neiaHsing/stm32-filament-dryer/docs/TEMPERATURE_CONTROL_ALGORITHM_REPORT.md

# 温度控制系统算法说明与实验报告依据

> 2026-09-17前馈更新：已实测24°C室温下40°C/60°C保温输出28.9611%/53.5925%，当前F22=clip(11.99435×(目标−12.83620),0,850)，再按(目标−室温)/(目标−22)缩放。此前20.13/34.65及旧表为历史值，以本条和`outputs/feedforward_calibration_24c/REPORT.md`为准；旧版实测不代表新曲线验证。

编写依据：2026-09-16 工作区当前源码及已有实测记录。本文不修改控制程序，也不启动设备。公式中的温度单位为 °C，时间为 s，控制输出为千分比（0～1000）。

## 1. 系统定位与总体结构

本系统针对 PTC 加热的烘干装置，通过 STM32 完成温湿度采集、加热功率调节和安全联锁，ESP32 用于状态记录与远程操作。控制对象是传感器所在位置的空气温度，不是耗材内部温度。

当前算法可准确表述为：**基于双传感器加权反馈、保温前馈、温度增益调度、趋势预测、条件积分和限幅降温补偿的离散 PID 型温控算法，外层叠加湿度滞回和安全状态机。**

它不是教科书中直接对温差作 P、I、D 叠加的固定参数 PID，也不是严格模型预测控制 MPC；程序没有在线优化求解器。所谓预测是利用当前升温斜率进行短时间线性外推。

功能链路为：

```text
AHT20 温湿度、BMP280 温度
          ↓ 数据有效性检查
融合温度 T = 0.7 TAHT + 0.3 TBMP ──→ 显示与遥测
          ↓
运行/启动等待/风扇/传感器/过温/湿度许可
          ↓
目标选择 → 保温前馈 + 预测比例 + 有界积分 + 单向微分 + 降温补偿
          ↓ 输出限幅与千分比量化
10 Hz PWM → XY-MOS → PTC → 箱内温度 → 传感器

原始两路温度的较高值 → 独立于融合计算的 75°C 过温判定
```

源码入口：`Core/Src/main.cpp`；核心控制器：`Core/Inc/separation_pid.h`；融合函数：`Core/Inc/temperature_fusion.h`。这里的“独立”指独立判据，过温保护仍是同一 MCU 上的软件功能，不是独立硬件温控器。

## 2. 被控对象特点及算法设计依据

可用下面的简化能量平衡解释设计意图：

\[
C_{eq}\frac{dT}{dt}=P_{eff}(u,T)-Q_{loss}(T,T_a)-Q_{load}-Q_{dist}.
\]

其中，等效热容反映箱体、空气和负载的热惯性；有效加热量受占空比、PTC 温度和供电条件影响；散热和开盖等扰动消耗热量。该式是分析模型，程序没有识别全部参数或实时计算这条方程。

由此可以解释：

1. 温差较大时通常需要较高输出，但接近目标后继续大功率加热会因热惯性发生超调。
2. 达到目标并不意味着可以永久关闭加热，稳态仍需补偿散热，因此引入保温前馈。
3. 温度升高后对象响应变慢，固定参数在不同温区未必具有相近效果，因此引入有界增益调度。
4. 开盖导致的短时掉温不宜全部记入积分，否则盖回后可能释放过多积累输出，因此冻结积分并限制下降趋势补偿。
5. 系统没有主动制冷输出。温度过高时只能减少或关闭加热，依靠原有风流和自然散热降温。

满占空比历史试验记录：30～40°C、40～50°C、50～60°C 的平均升温速度分别为 0.40464、0.36116、0.20173°C/s，支持对象响应随温度变化的判断。该试验采用旧版 max 温度反馈，且没有测电流、电压；“100% 占空比”不能写成“始终恒定 100 W”。

## 3. 温度采样、转换和融合

### 3.1 采样周期与执行周期

- 名义采样周期 1000 ms；AHT20 触发测量后等待至少 85 ms，再读取测量值并读取 BMP280 温度。
- 等待 AHT20 转换采用主循环状态管理，并非固定阻塞 85 ms；I²C 传输本身仍存在同步等待。
- 主循环末尾延时 2 ms，不代表 PID 每 2 ms 运算，也不代表安全反应时间严格等于 2 ms。
- 采样调度错过周期时跳过已错过时隙，不密集补采。
- AHT20 与 BMP280 并非硬件同步采样：BMP280 使用自身正常模式周期，主循环读取最近温度寄存器。

新样本的 PID 时间间隔按 AHT20 的触发时间戳计算：

\[
\Delta t_k=(tick_k-tick_{k-1})/1000.
\]

首次进入控制使用 1 s 初始化。只有新样本、目标变化或 PID 尚未初始化时才重新计算输出。

### 3.2 数据转换与传感器补偿

AHT20 使用 20 位原始数据换算：

\[
RH=100\frac{N_H}{2^{20}},\qquad T_A=200\frac{N_T}{2^{20}}-50.
\]

程序以 0.01°C 和 0.001%RH 整数存储，并检查忙状态及 CRC8，CRC 多项式为 0x31、初始值为 0xFF。

BMP280 从芯片读取 T1、T2、T3 校准参数，对原始温度 ADC 值作整数补偿。若用连续形式帮助理解，可写为：

\[
v_1=\left(\frac{ADC_T}{16384}-\frac{T_1}{1024}\right)T_2,
\]
\[
v_2=\left(\frac{ADC_T}{131072}-\frac{T_1}{8192}\right)^2T_3,
\qquad T_B\approx\frac{v_1+v_2}{5120}.
\]

实际执行的是 `bmp280.c` 中带移位和取整的整数公式，不是直接调用上述浮点式。芯片校准补偿属于测量处理；后文的保温和降温补偿属于控制输出处理，两者不可混称。

### 3.3 数据有效性及融合

两路温度均须位于 −40～85°C；相对湿度不得超过 100%RH；任一必要读数或通信校验失败，则整个温湿度样本无效。加热运行中不会自动退化成单传感器控制。

反馈量为：

\[
T_k=0.7T_{A,k}+0.3T_{B,k}.
\]

融合后保留到 0.01°C，正负数的恰好半步均向远离零的方向舍入。例如 39.70°C 与 40.10°C 得到 39.82°C。PID、显示、网页和遥测使用同一融合温度；OLED 的显示格式再取到 0.1°C。

0.7/0.3 是固定权重，当前实现不是卡尔曼滤波，也没有在线估计传感器置信度。加权平均可以改变两路噪声和偏差对结果的贡献，但若无独立标准温度计校准，不能宣称该比例必然最优或具有 0.01°C 的绝对测量精度。数值分辨率不等于准确度。

过温判据另外使用：

\[
T_{safe,k}=\max(T_{A,k},T_{B,k}).
\]

因此较低的一路不会通过加权平均掩盖另一路达到 75°C 的情况。当前代码没有额外的双传感器温差故障阈值。

## 4. 控制器变量、参数与总公式

定义限幅函数：

\[
\operatorname{clip}(x,a,b)=\min(\max(x,a),b).
\]

| 符号 | 物理意义 | 当前值或范围 |
|---|---|---|
| r | 温度目标 | 用户目标 30～70°C；温度关闭但湿度开启时取 70°C |
| e=r−T | 当前温差 | °C |
| u | 输出千分比 | 0～1000 |
| Kp | 比例基准系数 | 200 千分比/°C |
| Ki | 积分基准系数 | 2 千分比/(°C·s) |
| Kd | 微分基准系数 | 180 千分比·s/°C |
| Esep | 积分分离阈值 | 2°C |
| I | 积分输出修正 | −250～250 千分比 |
| v | 滤波温升速率 | °C/s，滤波时间常数参数 1 s |
| H | 近期输出滤波量 | 千分比，滤波时间常数参数 4 s |

内部浮点输出公式为：

\[
u_k=\operatorname{clip}(F_k+P_k+I_k+D_k+B_k,0,U_{max,k}).
\]

F 为保温前馈；P 为预测误差比例项；I 为残差积分；D 为单向升温制动；B 为限幅降温补偿。执行层将结果四舍五入到整数千分比后写入 PWM。

## 5. 保温前馈

\[
F_{22}(r)=\operatorname{clip}\left[11.99435(r-12.83620),0,850\right],
\qquad F(r,T_a)=\operatorname{clip}\left[F_{22}(r)\frac{\max(r-T_a,0)}{r-22},0,850\right].
\]

| 目标温度（室温设为 22°C） | 前馈千分比 | 对应占空比 |
|---|---:|---:|
| 30°C | 205.87 | 20.587% |
| 40°C | 325.81 | 32.581% |
| 50°C | 445.76 | 44.576% |
| 55°C | 505.73 | 50.573% |
| 60°C | 565.70 | 56.570% |
| 70°C | 685.64 | 68.564% |

2026-09-17 在 24°C 室温下实测目标 40°C 和 60°C 的末段平均保温输出分别为 289.61‰ 和 535.93‰，再归一化为 22°C 基准后拟合出斜率 11.99435、偏移量 12.83620。目标 40°C、22°C 室温时前馈约 32.581%，目标 60°C、22°C 室温时约 56.570%；其它目标和室温仍属于曲线估计。

`ROOM TEMP CAL` 菜单输入当前箱外室温 Ta（−10～50°C、1°C 步进，默认 22°C），按温差比例缩放新版前馈。所有合法目标为 30～70°C，分母始终为正；函数对目标不高于 22°C 或室温不低于目标的情况返回零前馈。以目标 40°C 为例，室温 10/22/28°C 对应约 54.302%/32.581%/21.721% 前馈；目标 60°C、室温 24°C 对应约 53.593%。当前曲线有两个目标点的实测支撑，仍需更多环境、负载和风量条件验证；只改变前馈及使用该前馈的下降补偿计算，传感器融合、满功率速率表、PID 参数和独立过温阈值不变。设置在停机菜单最终确认时应用，W25Q v3 保存室温，v1/v2 记录兼容回退至 22°C。完整数据见 `outputs/feedforward_calibration_24c/REPORT.md`。

前馈使系统在误差接近零时仍具有补偿散热的基础输出，积分只需修正前馈不准的部分。它不能保证所有装载和环境下的准确保温。前馈最高 85% 也不意味着总输出最高 85%；比例、积分等叠加后总输出仍可到 100%。

## 6. 温度相关增益调度

程序内置满占空比升温速度表，单位 °C/s：

| 温度节点 | 35.5 | 40.5 | 45.5 | 50.5 | 55.5 | 59.5 |
|---|---:|---:|---:|---:|---:|---:|
| R(T) | 0.4533 | 0.4346 | 0.3619 | 0.2761 | 0.2058 | 0.1420 |

节点间线性插值：

\[
R(T)=R_i+\frac{T-T_i}{T_{i+1}-T_i}(R_{i+1}-R_i).
\]

低于 35.5°C 保持首节点值，高于 59.5°C 保持末节点值，不继续外推下降曲线。该表是程序采用的平滑表，不能与历史报告的 5°C 分段平均值直接混用。

增益系数为：

\[
g_k=\operatorname{clip}\left(\frac{0.4346}{R(T_k)},0.8,2.0\right).
\]

P、I 增量、D 都乘以 g。40.5°C 时 g=1；50.5°C 时约 1.574；55.5°C 时比值约 2.112，实际限到 2。

设计意图是响应变慢时增强控制作用，同时避免无界放大。这属于经验增益调度；满功率净升温率不等同于任意工作点的小信号对象增益，也没有由此证明全温区稳定性。尤其 60～70°C 缺少相应速度标定，应在报告中列为验证边界。

## 7. 斜率滤波与预测减功率

### 7.1 测量微分及滤波

先算测量斜率：

\[
s_k=\frac{T_k-T_{k-1}}{\Delta t_k}.
\]

再进行一阶低通滤波：

\[
v_k=v_{k-1}+\frac{\Delta t_k}{1+\Delta t_k}(s_k-v_{k-1}).
\]

当 Δt=1 s 时，新斜率与上一滤波值的权重各为 0.5。滤波用于减小差分对测温噪声的放大；控制器没有另外对反馈温度作同样的时间低通。

微分作用于测量值，不直接对设定误差差分，因此目标阶跃不会人为产生一个由设定值跳变导致的巨大微分量。

### 7.2 近期输出与预测时间

\[
H_k=H_{k-1}+\frac{\Delta t_k}{4+\Delta t_k}(u_{k-1}-H_{k-1}),
\]
\[
L_k=1.7+0.5\frac{\operatorname{clip}(H_k,0,1000)}{1000}.
\]

L 在 1.7～2.2 s 之间。近期输出越高，采用的预测时间越长。H 是滤波输出代理量，虽在代码中命名为 heatMemory，但没有热容或能量单位，不能称为精确储热量估计。

只预测正向温升：

\[
v_k^+=\max(v_k,0),\quad \hat T_k=T_k+L_kv_k^+,
\]
\[
\hat e_k=r_k-\hat T_k,\qquad P_k=K_pg_k\hat e_k.
\]

例如，当前 39.7°C、目标 40°C、滤波升温率 0.2°C/s、预测时间 2 s，则预测温度 40.1°C。虽然当前仍低于目标，预测误差已为 −0.1°C，比例项开始减功率。

历史满功率截止试验中，触发样本之后约继续升温 0.24°C，除以关热前约 0.14509°C/s 的速度得到约 1.65 s，这为预测时间提供了经验参考。1 s 采样不能支持亚秒级精确辨识，也不能证明预测时间适用于所有工况。

### 7.3 单向微分项

\[
D_k=-K_dg_kv_k^+.
\]

升温时微分提供制动；下降时 D=0，下降补偿交给后面的 B 项处理。比例预测和微分都会对上升趋势制动，在同一个计算时刻可合写为：

\[
P_k+D_k=K_pg_ke_k-g_k(K_pL_k+K_d)v_k^+.
\]

因此整定时必须同时考虑预测时间和 Kd。提高任一个都可能加大接近目标时的减功率。当前算法已取消旧版额外的独立蓄热温升扣减，以免对同一上升趋势重复制动过强。

## 8. 降温补偿

满足 −0.20<e≤2.0°C 且 v<0 时启用：

\[
B_k=\operatorname{clip}\left[\frac{-v_k(1000-F_k)}{R(T_k)},0,100\right].
\]

否则 B=0。

这一项希望在温度刚开始下降、温差尚不明显时提前补热；最多增加 100 千分比，即 10 个占空比百分点。它使用满功率速率和剩余输出空间作经验换算，不是精确的热功率逆模型。

例如，F≈300、R≈0.435°C/s、v=−0.05°C/s，得到 B≈80.5，即增加约 8.05 个百分点。若速率使理论补偿超过 100，则仍只加 100。

温差超过 2°C 时关闭 B，大扰动主要由比例项、已有积分与前馈恢复；这不表示大幅掉温时停止加热。其意图是避免较大负斜率再叠加过强的额外助推。已经高于目标 0.2°C 或更多时也不启用该补偿。

## 9. 积分分离、扰动冻结和抗饱和

### 9.1 扰动冻结计时

冻结剩余时间 q 每次按 Δt 减少，下限为零。如果已有历史样本、Δt>0，且：

\[
e_k>0.4\quad\text{且}\quad(s_k<-0.10\ \text{或}\ v_k<-0.05),
\]

则 q 重新置为 12 s。连续掉温可连续重新触发，所以不应写成“首次掉温 12 s 后一定恢复积分”。

已有控制状态下目标改变时，q 至少设为 5 s。首次启动不自动设置这个 5 s 冻结。

### 9.2 允许积分的全部条件

只有以下条件同时成立才尝试更新积分：

1. |e|≤2°C；
2. q=0；
3. 不满足 e>0 且预测误差 ê≤0，即当前虽欠温但预计已到温时不继续正向积分。

正在升温时不再用 `|v|≤0.10°C/s` 作为硬门槛。若 e>0 且 v>0，积分增量乘以：

\[
\alpha=\operatorname{clip}\left(1-\frac{v}{0.30},0.25,1\right).
\]

因此温度上升越快，积分建立越慢，但仍会逐步建立；温度下降或已经高于目标时使用完整积分增量。积分候选值为：

\[
I_c=\operatorname{clip}(I_{k-1}+\alpha K_ig_ke_k\Delta t_k,-250,250).
\]

不满足积分条件时保留旧 I，并非一出积分分离区就清零。已有保温修正因此可以在短时扰动中继续发挥作用。

### 9.3 条件抗饱和

用候选积分计算：

\[
u_c=F+P+I_c+D+B.
\]

下列任一情况成立才接受候选积分：

- 0≤u_c≤Umax；
- u_c>Umax 且 e<0，积分变化有助于减小过大的输出；
- u_c<0 且 e>0，积分变化有助于从负饱和恢复。

否则保留旧积分。它是条件积分抗饱和，没有独立的反算跟踪项。

积分既有 ±250 的自身限幅，又有输出方向判定，加上温差、速率和冻结约束，主要承担慢速保温修正，不承担冷启动全程热量积累。积分有限且更新受条件限制，不能理论保证任何工况都消除稳态误差。

## 10. 输出上限、PWM 和执行机构

当前Umax=1000，输出在0–1000间连续限幅。目标+0.30°C强制停热是历史策略，当前代码不含该门槛；75°C锁存过温保护仍独立执行。

加热 PWM 参数：TIM4_CH3，72 MHz 定时器时钟，经 PSC=7199 分频到 10 kHz，ARR=999，得到 10 Hz，即每周期 100 ms、1000 个计数。比较值为：

\[
CCR3=\frac{(ARR+1)u_{int}}{1000}=u_{int}.
\]

例如 u=300 对应 30% 占空比，每 100 ms 约导通 30 ms。非零新比较值通常在下一 PWM 更新事件生效；输出切到零时额外触发更新，尽快落实停热。

PID 每秒计算一次，PWM 每 0.1 s 重复一次，在两次计算之间保持上次占空比。不要混淆控制采样频率与功率开关频率。

当前代码在有效温控调节阶段使电机持续开启，即使本次 PID 输出为零；电机为 TIM2_CH1、20 kHz 配置，当前占空比 100%。湿度达标暂停、启动等待、停止和故障则关闭电机。独立供电的风扇与该电机不同，软件关闭电机并不等于切断风扇电源。

## 11. 目标切换、控制时间和状态复位

- 运行中调高目标：保留现有积分及滤波温升趋势，避免丢失已建立的保温修正；目标变化至少冻结积分 5 s。
- 调低目标：I←min(I,0)，只丢弃正向积分，保留负向修正；同样冻结至少 5 s。
- 只有目标变化、没有新样本：Δt=0，仅重算输出，不推进积分、斜率滤波和输出历史滤波；但目标变化引起的积分裁剪及冻结设置仍执行。
- Δt<0、Δt>5 s，或 Δt=0 却没有可用历史/测量值变化：复位控制器并返回零输出。
- 停止、故障、湿度达标暂停及启动等待等关闭整套烘干输出时：清零积分、微分、输出历史和冻结计时，置为未初始化。

超过 5 s 的 dt 检查是在下一次调用控制器时生效，不能等同于程序已经实现一个持续检查“样本年龄超过 5 s 就立即停热”的独立看门狗。

## 12. 湿度外层与模式选择

默认目标为 55°C、20%RH，均启用；若读取到有效保存配置，则使用保存值。用户温度范围 30～70°C，湿度范围 10～80%RH。

| 温度目标 | 湿度目标 | 实际行为 |
|---|---|---|
| 开启 | 开启 | 湿度决定是否需要烘干，允许时按用户温度目标调节 |
| 开启 | 关闭 | 持续按温度目标调节 |
| 关闭 | 开启 | 湿度决定是否烘干，允许时以 70°C 为内部温控目标 |
| 关闭 | 关闭 | 不加热、电机关闭；独立风扇仍可持续吹风 |

湿度需求是一个带记忆状态 z：

\[
z_k=\begin{cases}
0,&RH_k\le RH_{set},\\
1,&RH_k\ge RH_{set}+2\%RH,\\
z_{k-1},&\text{其余情况}.
\end{cases}
\]

例如目标 20%RH：下降到 20%RH 或以下暂停，重新升到 22%RH 或以上恢复，中间保持上一次状态。这里是增加 2 个湿度百分点，不是乘以 1.02。启动时以 RH>目标 初始化需求，不必先达到目标+2。

湿度达标时任务仍处于运行监测状态，并非永久结束；输出关闭、PID 复位，湿度反弹后可恢复。当前没有独立湿度 PID、湿度温度解耦补偿或耗材含水率估计。相对湿度变化受温度影响，不能仅凭 RH 达标断言材料内部已达到某个含水率。

温度目标关闭而湿度控制仍启用时，70°C 是内部调节目标，不是任何瞬间均不超过 70°C 的硬截止；代码另有两路原始温度达到 75°C 的锁存故障保护。

## 13. 安全与运行许可

启动要求无锁存故障、风扇信号已有效且为运行状态；若启用任一种加热目标，还要求传感器有效且两路最高温度低于 75°C。

运行控制的主要顺序是：不运行或有故障→关闭输出；运行不足 6 s→关闭输出等待；之后检查风扇、模式、传感器和绝对过温；然后判断湿度需求；最后运行 PID。

| 条件 | 动作与恢复 |
|---|---|
| 启动后不足 6 s | PTC 和电机关闭；不是绕过启动风扇检查的宽限 |
| 风扇低电平连续 200 ms | 确认为运行 |
| 风扇高电平连续 500 ms | 确认为停止；运行保护触发后停止任务、关闭输出 |
| 风扇故障后恢复有效运行 | 自动清除风扇故障，但不自动重启任务 |
| 任一路必要传感器采集失败 | 加热任务停止，关闭输出，锁存传感器故障 |
| 任一路有效温度≥75°C | 停止任务并锁存过温故障 |
| 传感器断连 | 每约 2 s 恢复总线并重新探测；恢复显示不等于自动重启 |
| 清除传感器/过温故障 | 通常要求样本有效且两路均严格低于 70°C，并人工清除；温湿度均关闭时，传感器故障允许特殊清除 |
| 远程运行租约达到 5 s 未续期 | 停止任务、关闭 PTC 和电机 |
| MCU 异常处理 | 直接关闭相关定时器并将功率控制引脚置为关闭状态 |

风扇输入是锁转/运行状态，不是 RPM 测量；程序没有转速闭环。通信故障、过温等的“立即关闭”是指检测到后执行停热路径，仍受采样及任务调度延迟约束，不是零延迟物理响应。

远程还有开机 5 s RUN 防护、命令时间戳和序号检查、重复命令幂等处理。持久化写 Flash 只允许在停止状态执行，避免运行中长时间擦写阻塞安全循环。本地运行不依赖远程租约。

## 14. 一次运算示例

设目标 40°C，当前融合温度 39.8°C，当前滤波升温率 0.10°C/s，已更新的输出历史 H=300，积分 I=20。

1. e=0.20°C。
2. 插值得 R≈0.437218°C/s，g≈0.994。
3. 前馈 F=289.61（示例使用 24°C 室温；若按 22°C 基准则为 325.81）。
4. 预测时间 L=1.85 s，预测温度 39.985°C，预测误差约 0.015°C。
5. P≈200×0.994×0.015≈2.98。
6. D≈−180×0.994×0.10≈−17.89。
7. 温度正在上升，B=0。
8. 若冻结计时已结束且其他条件允许，v=0.10°C/s 时 α≈0.667，Δt=1 s 时 I 增加约 0.265；否则仍为 20。
9. 输出约 113.0～113.3 千分比，即约 11.3%。

这一示例说明：接近目标时不是简单关闭加热，而是在保温基础上用趋势和小误差修正功率。示例假定已有控制历史，不能作为首次启动调用的结果。

## 15. 实测证据及版本边界

### 15.1 早期 max 反馈试验

`outputs/pid_strategy_40c/REPORT.md` 的 trial04 使用两路温度较高值作为反馈：持续约 360 s，首次到 40°C 约 32.0 s，峰值 40.13°C，最后 120 s 范围 40.08～40.13°C，平均绝对误差 0.107°C，平均占空比 26.63%。

这些结果支持当时工况下的策略有效性，但不能直接标成当前加权融合版性能。四轮测试的初温、内部蓄热及持续时间不同，也不能用到温时间之比宣称严格的性能提升倍数。

### 15.2 融合部署后的开盖扰动记录

较新的 `outputs/pid_strategy_40c/live_open_lid_20260916/` 保存 300 s 实验记录，时间顺序位于融合固件烧录之后，数据采用新版单一 `temperature_c` 字段。结合部署记录，可作为融合版本实测参考；该次实验结果文件本身未记录固件哈希，后续正式实验宜把哈希写入试验元数据。

条件：目标 40°C、湿度控制关闭、Kp=200、Ki=2、Kd=180、积分分离阈值 2°C。按加热开始的 STM32 tick 与采集窗口筛选，有 301 个正式样本，覆盖约 300 s。

| 指标 | 记录结果 |
|---|---:|
| 加热起点温度 | 33.23°C |
| 首次达到 40°C | 约 26.7 s |
| 全程峰值/首次超调 | 40.34°C / +0.34°C |
| 深度扰动最低温度 | 35.78°C |
| 深度扰动最低点后首次回到 ±0.2°C | 约 14.2 s |
| 恢复后的短暂峰值 | 约 40.31°C |
| 最后 60 s 温度范围 | 39.85～40.04°C |
| 最后 60 s 平均温度 | 39.941°C |
| 最后 60 s MAE | 约 0.064°C |
| 最后 60 s RMSE | 约 0.079°C |
| 最后 60 s 平均占空比 | 约 30.38% |

本次编写时使用 `gateway_history.csv`，按命令会话、序号、首个加热 tick 及 `samples.csv` 的采集结束 tick 筛选，复算尾段平均温度 39.9405°C、MAE 0.0641667°C、RMSE 0.0786871°C、平均占空比 30.375%，与已有报告舍入后相符。

14.2 s 是“扰动最低点到首次重新进入误差带”的恢复时间，不是盖回后精确恢复时间，也不是永久保持在带内的调节时间。记录中没有人工开盖/盖回动作时间标记；恢复后又短暂超调，约第 216 s 才重新进入 ±0.2°C 并保持到本轮结束。

本轮尾段表明在该条件下控制误差较小，但不能把 MAE=0.064°C 写成传感器绝对准确度，也不能推广为 30～70°C 全温区或所有负载都达到该性能。

### 15.3 逻辑验证

本次重新运行已有 `tests/separation_pid_test.cpp` 和 `tests/test_temperature_fusion.py`，均通过。覆盖积分限幅、目标切换、下降补偿、异常时间间隔、相同样本重算、融合舍入及真实控制函数的部分安全边界等。PID 测试含三种简化热模型；这些测试说明相应软件逻辑通过断言，不替代实物温场、故障断电和长期稳定性试验。

## 16. 实验报告的组织和评价方法

建议分为：实验目的；硬件与采样；控制算法及公式；参数来源；实验方案；结果；误差与局限分析。

至少记录固件版本/哈希、反馈定义、目标值、负载、传感器位置、初温、环境条件、供电条件、风扇状态、湿度是否启用以及开盖动作时刻。仅比较 PID 温控性能时应关闭湿度门控，避免 RH 达标导致停热而误判为温控问题。

建议数据列包含 STM32 时间戳、两路原始温度（若有专门采集手段）、融合温度、目标、占空比、湿度、风扇状态和故障标志；为验证机制，可增记滤波斜率、前馈、P/I/D/B 分项、预测温度及冻结计时。当前正式遥测没有全部这些内部量，不能声称它们已被直接测得。

误差与评价指标：

\[
e_k=r-T_k,\quad MAE=\frac1N\sum|e_k|,\quad RMSE=\sqrt{\frac1N\sum e_k^2}.
\]
\[
\Delta T_{over}=\max(0,\max T_k-r),\quad
\Delta T_{pp}=\max T_k-\min T_k.
\]

- 稳态 MAE、均值和峰峰值须注明统计时间窗口。
- 首次到温时间与持续进入误差带的调节时间分别报告。
- 扰动评价分别报告最大温降、首次恢复时间、二次超调及最终稳定时间。
- 采样不均匀时，样本平均与时间加权平均不同，应说明采用哪一种。
- 遥测在主循环中先于该次普通控制更新发送，新温度与上一次输出可能出现在同一帧；分析输出转折时应考虑约一个采样周期的对应关系。
- 如需绝对测温误差，需引入独立校准参考；如需能耗，需测电功率。平均占空比只表示控制指令强度，不能直接等同实测电能。

推荐后续对照实验：保持相同融合方式、环境和负载，分别取消前馈、预测、降温补偿或积分冻结，观察到温、超调和恢复变化；每次只改变一项，重复多轮。当前已有历史试验不构成这类严格消融对照，因此算法各机制的独立贡献尚不能精确量化。

## 17. 可用于报告的概述文字

本系统采用双温度传感器加权反馈的离散 PID 型温控方法，以 AHT20 和 BMP280 温度的 0.7/0.3 加权值作为控制量。控制器在保温前馈基础上，依据实测满占空比升温速率调整控制增益，利用滤波温升率及近期输出估计短时温升趋势，提前降低接近设定值时的加热输出。积分在小误差且无扰动冻结时更新；升温期间根据温升速度缩小积分增量，并通过积分限幅和条件积分抑制饱和。接近目标的下降趋势触发最大 10 个占空比百分点的补偿，大幅掉温主要由比例作用和保留的积分修正恢复。外层采用湿度滞回控制烘干需求，并通过风扇状态、传感器有效性、双路原始温度过温判定及远程租约约束运行。现有 40°C 开盖扰动记录显示，末段 60 s 融合温度位于 39.85～40.04°C，平均绝对误差约 0.064°C；该结果限于本次工况和传感器反馈，不代表全温区性能或绝对测温精度。

## 18. 依据索引与文档冲突处理

- `Core/Inc/separation_pid.h`：全部控制器状态、前馈、速率表、预测、积分、补偿和限幅。
- `Core/Inc/temperature_fusion.h`：融合权重及舍入。
- `Core/Src/main.cpp`：默认参数、模式、采样调度、PWM、安全状态机、故障处理、遥测顺序。
- `Core/Src/aht20.c`、`Core/Src/bmp280.c`：转换公式、校验及传感器校准补偿。
- `outputs/full_power_60c/REPORT.md`：满占空比温升及关热余热依据，旧 max 反馈。
- `outputs/pid_strategy_40c/REPORT.md`：早期四轮调参结果，旧 max 反馈。
- `outputs/temperature_fusion_v2/README.md` 及其 `deployment/`：融合实现与部署记录。
- `outputs/pid_strategy_40c/live_open_lid_20260916/analysis.md`、CSV、JSON：较新的开盖扰动记录。

已有文档存在时间先后和部分过时表述：旧策略报告称尚未验证开盖恢复，但随后已有本节引用的开盖记录；融合构建/部署说明中的“尚未实测”或联网验收状态也属于当时记录，不可覆盖后续实验。`CONTROL_SYSTEM.md` 下部“电机只在 PTC 实际加热时旋转”的句子与当前 `UpdateControl` 不一致，本文以源码“温控期间零加热也保持电机开启”为准。另有 1°C 温度滞回常量仍在代码中声明，但当前 PID 路径未使用，报告不应把它写成已生效温度控制规则。
