neiaHsing/stm32-filament-dryer/docs/STM32F103C8T6_PIN_CONNECTIONS.md

# STM32F103C8T6 接线说明

本文档给出 3D 打印耗材烘干机控制板中 STM32F103C8T6 的完整接线方案。

- 芯片型号：STM32F103C8T6
- 封装：LQFP48，7 mm x 7 mm
- 工作电压：3.3 V
- 物理引脚编号依据：[STM32F103x8/xB 官方数据手册](https://www.st.com/resource/en/datasheet/stm32f103c8.pdf)

## 1. 状态说明

| 状态 | 含义 |
|---|---|
| 必接 | MCU 正常工作所必需的电源、复位、启动或时钟连接 |
| 当前使用 | 已在当前固件中配置并使用 |
| 规划 | 为电机驱动或安全继电器预留，当前固件尚未配置 |
| 保留 | 当前不连接，可设置测试点或留作后续扩展 |

## 2. LQFP48 完整引脚连接表

| 物理脚号 | 引脚名称 | 网络或外设 | 状态 | 接线说明 |
|---:|---|---|---|---|
| 1 | VBAT | 3V3 | 必接 | 无后备电池时连接 3V3，建议就近放置 100 nF 电容 |
| 2 | PC13-TAMPER-RTC | HEATER_LED | 当前使用 | 加热状态 LED，推荐 `3V3 -> 2.2 kΩ -> LED -> PC13`，低电平点亮 |
| 3 | PC14-OSC32_IN | LSE_IN/NC | 保留 | 未使用 RTC 晶振时悬空；需要 RTC 时接 32.768 kHz 晶振 |
| 4 | PC15-OSC32_OUT | LSE_OUT/NC | 保留 | 未使用 RTC 晶振时悬空；需要 RTC 时接 32.768 kHz 晶振 |
| 5 | PD0-OSC_IN | HSE_IN | 必接 | 接 8 MHz 晶振 X1 一端，并从该端接 30 pF 到 GND |
| 6 | PD1-OSC_OUT | HSE_OUT | 必接 | 接 8 MHz 晶振 X1 另一端，并从该端接 30 pF 到 GND |
| 7 | NRST | RESET | 必接 | 10 kΩ 上拉到 3V3，100 nF 接 GND；可增加按键到 GND，并引出到调试接口 |
| 8 | VSSA | GND | 必接 | 模拟地，连接完整地平面 |
| 9 | VDDA | 3V3A | 必接 | 3V3 经磁珠 FB1 接入，VDDA 附近放置 100 nF 和 1 uF 到 GND |
| 10 | PA0-WKUP | MOTOR_IN1 | 当前使用 | 连接 DRV8870 IN1，TIM2_CH1 输出 20 kHz PWM |
| 11 | PA1 | BUTTON | 当前配置 | 当前配置为下拉输入，若安装独立按键，按键另一端连接 3V3；主应用暂未使用 |
| 12 | PA2 | MOTOR_IN2 | 当前使用 | 连接 DRV8870 IN2，当前正转时保持低电平 |
| 13 | PA3 | RELAY_EN | 规划 | 经 1 kΩ 接 AO3400A 栅极，并使用 100 kΩ 栅极下拉，控制加热安全继电器 |
| 14 | PA4 | TP_PA4/NC | 保留 | 当前不连接，可放置测试点 |
| 15 | PA5 | FLASH_SCK | 当前使用 | 连接 W25Q32 CLK/SCK，SPI1 时钟 |
| 16 | PA6 | FLASH_MISO | 当前使用 | 连接 W25Q32 DO/MISO |
| 17 | PA7 | FLASH_MOSI | 当前使用 | 连接 W25Q32 DI/MOSI |
| 18 | PB0 | ENC_S2 | 当前使用 | 连接旋转编码器 DT/S2，使用 10 kΩ 上拉到 3V3 和 100 nF 到 GND 消抖 |
| 19 | PB1 | ENC_KEY | 当前使用 | 连接编码器按键，使用 10 kΩ 上拉和 100 nF 消抖，按下时接 GND |
| 20 | PB2/BOOT1 | BOOT1/NC | 保留 | 建议使用 10 kΩ 下拉到 GND，使启动状态确定 |
| 21 | PB10 | SENSOR_SCL | 当前使用 | AHT20+BMP280 的 I2C2 SCL，4.7 kΩ 上拉到 3V3，可串联 33 Ω 后接传感器接口 |
| 22 | PB11 | SENSOR_SDA | 当前使用 | AHT20+BMP280 的 I2C2 SDA，4.7 kΩ 上拉到 3V3，可串联 33 Ω 后接传感器接口 |
| 23 | VSS_1 | GND | 必接 | 数字地，连接完整地平面 |
| 24 | VDD_1 | 3V3 | 必接 | 连接 3V3，紧贴该引脚放置 100 nF 去耦电容 |
| 25 | PB12 | ENC_S1 | 当前使用 | 连接旋转编码器 CLK/S1，使用 10 kΩ 上拉到 3V3 和 100 nF 到 GND 消抖 |
| 26 | PB13 | ESP32_SCK | 当前使用 | SPI2 模式 1 时钟，连接 ESP32 GPIO18 |
| 27 | PB14 | ESP32_CS | 当前使用 | 低电平片选，连接 ESP32 GPIO27 |
| 28 | PB15 | ESP32_SDIO | 当前使用 | 半双工数据，连接 ESP32 GPIO23；分时发送状态和接收命令 |
| 29 | PA8 | FAN_LOCK | 当前使用 | 风扇黄色 LOCK 线经 1 kΩ 串联接入，使用 4.7 kΩ 上拉到 3V3 |
| 30 | PA9 | TP_PA9/NC | 保留 | 当前不连接，可放置测试点 |
| 31 | PA10 | TP_PA10/NC | 保留 | 当前不连接，可放置测试点 |
| 32 | PA11 | USB_DM/NC | 保留 | 当前不连接，可用于 USB D- |
| 33 | PA12 | USB_DP/NC | 保留 | 当前不连接，可用于 USB D+ |
| 34 | PA13 | SWDIO | 当前使用 | 连接 ST-Link SWDIO |
| 35 | VSS_2 | GND | 必接 | 数字地，连接完整地平面 |
| 36 | VDD_2 | 3V3 | 必接 | 连接 3V3，紧贴该引脚放置 100 nF 去耦电容 |
| 37 | PA14 | SWCLK | 当前使用 | 连接 ST-Link SWCLK |
| 38 | PA15 | JTDI/NC | 保留 | 上电后默认为 JTAG 引脚，作为 GPIO 使用前需要在程序中关闭 JTAG 或进行 SWJ 重映射 |
| 39 | PB3 | JTDO/SWO/NC | 保留 | 上电后默认为 JTAG/SWO 引脚，作为 GPIO 使用前需要进行 SWJ 重映射 |
| 40 | PB4 | NJTRST/NC | 保留 | 上电后默认为 JTAG 引脚，作为 GPIO 使用前需要进行 SWJ 重映射 |
| 41 | PB5 | TP_PB5/NC | 保留 | 当前不连接，可作为普通 GPIO 或后续扩展接口 |
| 42 | PB6 | OLED_SCL | 当前使用 | SSD1306 的 I2C1 SCL；若屏幕模块没有上拉电阻，增加 4.7 kΩ 上拉到 3V3 |
| 43 | PB7 | OLED_SDA | 当前使用 | SSD1306 的 I2C1 SDA；若屏幕模块没有上拉电阻，增加 4.7 kΩ 上拉到 3V3 |
| 44 | BOOT0 | BOOT0 | 必接 | 使用 10 kΩ 下拉到 GND，可增加跳线或按键接 3V3 进入系统存储器启动模式 |
| 45 | PB8 | PTC_PWM | 当前使用 | TIM4_CH3，10 Hz 高电平有效 PWM；经 1 kΩ 接 TC4420 输入，TC4420 输入端使用 100 kΩ 下拉 |
| 46 | PB9 | FLASH_CS | 当前使用 | 连接 W25Q32 CS#，低电平片选，使用 10 kΩ 上拉到 3V3 |
| 47 | VSS_3 | GND | 必接 | 数字地，连接完整地平面 |
| 48 | VDD_3 | 3V3 | 必接 | 连接 3V3，紧贴该引脚放置 100 nF 去耦电容 |

## 3. 外部接口定义

### 3.1 AHT20+BMP280 温湿度传感器

| 接口脚 | 信号 | STM32 |
|---:|---|---|
| 1 | 3V3 | 电源 |
| 2 | GND | 地 |
| 3 | SENSOR_SCL | PB10 |
| 4 | SENSOR_SDA | PB11 |

SCL 和 SDA 分别使用约 4.7 kΩ 电阻上拉到 3.3 V。不得上拉到 5 V。

### 3.2 SSD1306 OLED

| 接口脚 | 信号 | STM32 |
|---:|---|---|
| 1 | 3V3 | 电源 |
| 2 | GND | 地 |
| 3 | OLED_SCL | PB6 |
| 4 | OLED_SDA | PB7 |

屏幕模块若已安装 I2C 上拉电阻，主板上的 4.7 kΩ 上拉可以不安装。

### 3.3 旋转编码器

| 接口脚 | 信号 | STM32 |
|---:|---|---|
| 1 | 3V3 | 电源 |
| 2 | GND | 地 |
| 3 | ENC_S1/CLK | PB12 |
| 4 | ENC_S2/DT | PB0 |
| 5 | ENC_KEY/SW | PB1 |

### 3.4 W25Q32 SPI Flash

| Flash 信号 | STM32 |
|---|---|
| CLK/SCK | PA5 |
| DO/MISO | PA6 |
| DI/MOSI | PA7 |
| CS# | PB9 |
| VCC | 3V3 |
| GND | GND |

W25Q32 的 WP# 和 HOLD# 使用 10 kΩ 上拉到 3V3。

### 3.5 XY-MOS 与 PTC 控制

```text
PB8/TIM4_CH3
    |
   1 kΩ
    |
TC4420 IN
    |
TC4420 OUT
    |
   33 Ω
    |
XY-MOS IN
```

- TC4420 使用 5 V 供电。
- TC4420 输入端增加 100 kΩ 下拉到 GND，确保上电时关闭加热。
- 当前固件使用 10 Hz、高电平有效的 PWM 控制。
- PTC 的 12 V、100 W 主电流不得流经 STM32 控制板的小信号走线。

### 3.6 Nidec 三线风扇

| 风扇线 | 连接 |
|---|---|
| 红线 | 12V |
| 黑线 | 系统电源 GND |
| 黄线 | 经 1 kΩ 接 PA8，并用 4.7 kΩ 上拉到 3V3 |

黄线在本项目中作为 LOCK 状态信号：

- 低电平：`FAN: RUN`
- 高电平持续超过设定时间：`FAN: STOP`
- 该信号不能用于计算准确 RPM

### 3.7 SWD 调试接口

至少引出以下信号：

| 信号 | STM32 |
|---|---|
| 3V3 | MCU 3.3 V 电源 |
| GND | MCU GND |
| SWDIO | PA13 |
| SWCLK | PA14 |
| NRST | 引脚 7，推荐引出 |

### 3.8 JGB37-520 电机接线

所选 JGB37-520 是没有编码器的两线直流减速电机：

```text
DRV8870 OUT1 / J2-1 -------- 电机线 A
DRV8870 OUT2 / J2-2 -------- 电机线 B
```

两根电机线不连接 STM32。交换两根电机线会改变默认旋转方向。PA9、PA10 均保持悬空或只放测试点，不要把它们当作 JGB37-520 编码器接口，也不要安装编码器上拉或电平转换电路。

没有编码器时，系统只能使用 PWM 开环调速，不能显示真实转速，也不能通过软件确认电机是否旋转。若后续需要卡料检测，应另加霍尔传感器、光电传感器或电流检测放大器。

### 3.9 DRV8870DDAR 接线

| DRV8870 脚号 | 名称 | 连接 |
|---:|---|---|
| 1 | GND | 驱动器功率地汇合点 |
| 2 | IN2 | PA2 GPIO 输出，保留 TIM2_CH3 反转调速能力 |
| 3 | IN1 | PA0/TIM2_CH1 |
| 4 | VREF | 3V3 经 1kΩ 接入，并在 VREF 端放置 100nF 到 GND |
| 5 | VM | 12V_MOTOR，附近放置 100nF 和至少 100uF/25V |
| 6 | OUT1 | 电机端子 1 |
| 7 | ISEN | 经 R_ISEN、1%、至少 1W 低感电阻接地，首版标注 `0.22Ω/1W, TBD` |
| 8 | OUT2 | 电机端子 2 |
| PowerPAD | PAD | 大面积接地铜和多颗散热过孔 |

限流典型值按 `ITRIP = VREF / (10 × R_ISEN)` 计算。在 `VREF=3.3V` 时，0.30Ω、0.22Ω、0.15Ω 分别对应约 1.10A、1.50A、2.20A。JGB37-520 不同版本的电流差异较大，最终阻值必须依据实测带载启动电流和短时堵转电流确定。

推荐控制方式：

| PA0/IN1 | PA2/IN2 | 电机状态 |
|---:|---:|---|
| 0 | 0 | 滑行停止并进入休眠 |
| 1 | 0 | 正转 |
| 0 | 1 | 反转 |
| 1 | 1 | 刹车 |

正转调速使用 `PA0=20kHz PWM、PA2=0`，反转调速使用 `PA0=0、PA2=20kHz PWM`。

当前固件使用正转模式：PTC实际加热时PA0输出20kHz PWM、PA2保持低电平；等待、保持、只吹风、任务停止或发生故障时两路均为低电平。默认占空比为100%，可修改 `Core/Src/main.cpp` 中的 `kMotorDutyPercent`。

### 3.10 ESP32-S 监控与控制网关

| 方向 | STM32F103 | ESP32-S | 说明 |
|---|---|---|---|
| STM32 → ESP32 | PB13 | GPIO18 | SPI2 SCK，模式 1，由 STM32 输出 |
| STM32 → ESP32 | PB14 | GPIO27 | 低电平片选 CS，由 STM32 输出 |
| 双向、分时 | PB15 | GPIO23 | 半双工 SDIO：64 B 状态上行、64 B 命令下行 |
| — | GND | GND | 两块板共地 |

只需 PB13、PB14、PB15 和 GND 四根连接线，没有独立 MISO 或 UART 线。PA9、PA10 和 ESP32 GPIO17 均保持未使用。ESP32 建议通过自身 USB/5V 输入供电，不从 STM32 板的 3.3V 稳压器取电。PB15 与 GPIO23 建议串联 330 Ω～1 kΩ；现有直连可先在任务停止、PTC 和电机断开的条件下验证。

STM32 每秒先用固定 64 字节、带 CRC16 的二进制事务发送温湿度、任务、输出、目标、故障和命令确认，再将 PB15 切为输入，约 20 ms 后用固定 64 字节事务读取 ESP32 命令；下行结束后留约 1 ms 换向。命令带 CRC16、会话号和序号；远程任务由 ESP32 每秒续租，STM32 在 5 秒收不到续租时安全停机。网页控制仍经过风扇、传感器和过温联锁。提交命令到收到下一帧确认通常约需 1～2 秒。详细协议、HTTP API 和网页使用方法见 [ESP32 网关说明](../esp32_gateway/README.md)。

经典 ESP32 的 ESP-IDF 不公开支持三线 SPI 从机 SIO；本项目通过 GPIO matrix 将 GPIO23 同时接到从机输入和输出，并严格按时隙控制输出使能。该 workaround 只适用于本项目固定协议。

## 4. 电源与布线要求

1. VDD_1、VDD_2、VDD_3 必须全部连接到 3V3。
2. VSS_1、VSS_2、VSS_3 和 VSSA 必须全部连接到 GND。
3. 每个 VDD 引脚附近放置一颗 100 nF 去耦电容，电容到芯片引脚的走线应尽量短。
4. MCU 附近增加一颗 4.7 uF 至 10 uF 的总旁路电容。
5. VDDA 使用磁珠从 3V3 分出 3V3A，并使用 100 nF 和 1 uF 去耦。
6. 8 MHz 晶振和负载电容必须靠近引脚 5、6，晶振区域下方不要穿过高速信号。
7. STM32、W25Q32、OLED 和传感器均使用 3.3 V，禁止直接连接 5 V 或 12 V 信号。
8. 非隔离控制方式下，STM32、TC4420、DRV8870 和 12 V 电源负极需要共用参考地。
9. 接入 XY-MOS 前应使用万用表确认控制 GND、功率负极和接线极性，发现异常电压或短路时不得直接连接。
10. PA0、PA2 已用于 DRV8870；PA3 仍为安全继电器规划引脚；PB13～PB15 用于 ESP32-S 半双工通信，PA9、PA10 保持 NC。

## 5. 工程配置依据

- [当前引脚宏定义](../Core/Inc/main.h)
- [STM32CubeMX 配置](../demo_led.ioc)
- [控制系统说明](../CONTROL_SYSTEM.md)
- [硬件设计与 BOM](HARDWARE_DESIGN_BOM.md)
