neiaHsing/stm32-filament-dryer/outputs/feedforward_calibration_24c/REPORT.md

# 24°C 室温前馈校准（2026-09-17）

实际箱外室温由用户提供为24°C；箱内起点26.90°C，未等待箱内降至24°C。保持闭环控制，湿度暂停关闭。源代码默认 PID 为160/2/180。两段结束后 STOP 已确认，加热0、电机关闭、无故障。

## 测量结果

| 目标 | 首次到达目标（阶段内秒） | 恒温计时 | 峰值 | 末120秒温度范围 | 末120秒平均输出 |
|---|---:|---:|---:|---|---:|
|40°C|223.1|300.4秒|40.14°C|40.07–40.14°C|28.9611%|
|60°C|122.6|569.0秒|60.16°C|60.00–60.10°C|53.5925%|

40°C段38→40°C耗时177.7秒。60°C段从40.08°C开始。到温时间按首次达到目标的采样计算；恒温计时按±0.2°C带计算，所以可早于首次达到整数目标开始。两段有效样本480/642个，最大采样间隔1.002秒。完整原始HTTP响应保存在raw_status.jsonl；samples.csv为按STM32 tick去重的记录。history容量900，不应代替完整的samples.csv。

平均输出使用STM32时间戳对末120秒作前值保持时间加权。稳态窗口仍有轻微热漂移，因此这是本次工况的有限时长估计；没有测电压、电流、负载重量，也没有独立温度计校准。判断条件是持续±0.2°C至少300秒，末120秒温差≤0.3°C，窗口头尾约30秒均温差<0.05°C、平均输出差<10‰。60°C因功率继续回落延长采集。

## 更新曲线

将实测总占空比（包含积分补偿）换算为22°C参考点：

```
U22 = U24 × (目标−22)/(目标−24)
40°C: 325.8120‰
60°C: 565.6990‰
F22 = clip(11.99435 × (目标−12.83620), 0, 850)
F = clip(F22 × max(目标−室温,0)/(目标−22), 0, 850)
```

两个参数替换Core/Inc/separation_pid.h中的旧20.13和34.65，积分、P/D参数保持原值。24°C室温下40°C前馈从95.73‰提高至289.61‰，60°C从483.44‰提高至535.93‰。主要修正是40°C基础功率不足。

40–60°C之间为两点插值；区间外和其它室温为估计，尚未验证。实测温度均值略高于目标（40.1009/60.0442°C），拟合将其视为对应目标附近的保温点，存在小幅偏差。

## 验证边界

主机PID、融合和安全测试通过；STM32构建成功。简化热模型新曲线40°C峰值40.413–40.483°C，未超过已有测试上限41°C，但提示提高前馈可能增加首次超调。上述实机曲线来自更新前固件，不能证明新曲线已达到≤0.3°C超调；更新后的完整冷启动验证尚未执行。

温度和占空比

## 刷写与最终状态

新前馈固件已通过OpenOCD写入、Verified OK并复位。日志flash.log；BIN哈希firmware_after.sha256。刷写后停机、输出0、电机关闭、无故障、室温24°C已在RAM应用（final_status.json）。

持久化设置请求返回storage_failed（ack_result=10），因此24°C不能保证断电保存，重启后需重新设置。未改动22°C参考常数，以免改变曲线归一化定义。
