neiaHsing/stm32-filament-dryer/outputs/steps_50_52_baseline/REPORT.md

# 新前馈50→52°C阶跃基线

固件70f21cb2a2c5425e3c780adcd07a73a8717600164a3097972b70600078068554，室温24°C，PID160/2/180。已冷却至38.73°C后开始。

|阶段|首次到温|±0.2°C稳态时间|峰值超调|稳态后观测|末120秒温度|末120秒平均输出|
|---|---:|---:|---:|---:|---|---:|
|38.66→50|42.0s|54.0s|0.35°C|235s|50.03–50.08|39.18%|
|50→52|19.0s|16.0s|0.13°C|180s|52.00–52.06|41.56%|

时间从首次遥测确认新目标开始，受1s采样与传输延时限制。稳态时间为从此刻起直到阶段结束都处于±0.2°C的最早时刻，并有至少180s后续观察。功率稳定门槛是额外的校准条件，不将该等待计入温度稳态时间。最大帧间隔1.002s；结束STOP确认、输出0、电机关闭，无故障。

结论：50→52没有明显拖尾；但新前馈首次升至50仍有0.35°C超调。尚不能用这一次热机阶跃证明冷启动或其它温区同等性能。后续按用户授权进行Kp200对比及52→54补充试验。
