neiaHsing/stm32-filament-dryer/outputs/temperature_optimization/REPORT.md

# 前馈与小幅升温优化结果

## 最终参数与部署

前馈F22=clip(11.99435×(目标−12.83620),0,850)，按(目标−室温)/(目标−22)缩放。PID默认从160/2/180改为200/2/180。OpenOCD已写入、Verified OK并复位；停机时回读RAM得到Kd=0x43340000=180，Ki=0x40000000=2，Kp=0x43480000=200。对应flash.log、pid_readback.log、firmware.sha256、final.bin/elf。

## 比较结果

|参数与阶段|首次到温|±0.2°C稳态|超调|稳态后观察|末120秒温度|
|---|---:|---:|---:|---:|---|
|160/2/180，38.66→50°C|42s|54s|0.35°C|235s|50.03–50.08°C|
|160/2/180，50→52°C|19s|16s|0.13°C|180s|52.00–52.06°C|
|200/2/180，40.37→50°C|37s|51s|0.46°C|185s|49.99–50.06°C|
|200/2/180，50→52°C|16s|13s|0.16°C|180s|51.98–52.05°C|
|200/2/180，52→54°C|15s|13s|0.17°C|186s|53.99–54.05°C|

稳态时间从首次遥测确认目标的STM32 tick起，取之后到阶段结束始终处于±0.2°C的最早采样，并要求至少180秒后续观察。额外等待功率稳定不计为温度稳态时间。时间分辨率约1秒；最大帧间隔2.001秒，未插值补造数据。

## 参数选择

针对小幅升温，200/2/180的50→52稳态缩短3秒（约19%），超调增加0.03°C；52→54同样13秒稳态、超调0.17°C。因此选用200/2/180并固化。中间点50/52/54末段平均输出约39.65%/41.88%/44.24%，作为补充数据保存；热状态存在慢漂移，不因一次中间点测量重新改写前馈。

首次大幅升温观察到0.46°C超调，高于基线0.35°C；起点及内部热状态不同，不能将差值全部归因于Kp。各小阶跃只做一次，3秒改善是本次观察，不是重复试验统计结论。没有证明全温区最优或其它负载/风量/室温下同等性能。新旧40°C冷启动也没有同工况比较，不宣称38→40提速倍数。

实机测试采用同一前馈及控制算法，通过RAM设置200/2/180验证后仅修改默认Kp。主机PID、融合/安全回归、构建和diff检查通过；刷写后回读证明同参数生效。

## 数据与最后状态

原始数据见../steps_50_52_baseline及../steps_50_52_54_kp200中的samples.csv/raw_status.jsonl/result.json/metrics.json。可用tools/analyze_temperature_steps.py复算。所有本轮实验已正常结束，停止命令序号13确认，加热0、电机关闭、无故障。

刷写后已发送序号16的停止/室温24°C设置。最后核查发现外部发出的序号17运行命令：目标44°C、室温24°C、正在加热、无故障（final_status.json）。本实验脚本未发该命令，进程检查无本地实验脚本存活；用户随后确认是在网页启动44°C，并明确要求保持运行；因此保留44°C运行，不执行停止。

外部设置存储曾返回storage_failed，24°C仅在RAM中应用，复位后需重新设置。前馈系数与默认PID编入STM32内部Flash，不依赖该外部存储。
