neiaHsing/stm32-filament-dryer/outputs/three_stage_20260916_214508/analysis_report.md

# 三阶段温控测试数据分析

测试记录目录：`outputs/three_stage_20260916_214508`

温度采用网关上报的融合反馈温度。稳态时间定义为：从对应阶段启动开始，到后续该阶段所有采样均保持在目标值 ±0.2°C 内的时间。另列出 ±0.5°C 控制带结果；本次 2 分钟恒温计时采用该控制带。

## 结果

| 阶段 | 达到目标 | 稳态时间（±0.2°C） | 控制带时间（±0.5°C） | 峰值 | 超调量 | 恒温尾段均值 | 尾段范围 |
|---|---:|---:|---:|---:|---:|---:|---:|
| 室温 → 40°C | 39.9s（阶段内 36.9s） | 73.3s | 36.1s | 40.18°C | +0.18°C | 39.96°C | 39.72–40.18°C |
| 40°C → 70°C | 310.3s（阶段内 151.4s） | 148.4s | 145.2s | 70.20°C | +0.20°C | 70.10°C | 69.67–70.20°C |

两段均完成约 120 秒恒温：40°C 段 120.4s，70°C 段 120.1s。无传感器、风扇或过温故障。

## 开盖动态过程

- 开盖记录时长：9.92s，共 11 个有效采样。
- 温度：70.21°C → 65.12°C，下降 5.09°C。
- 记录区间平均温降速率：−30.78°C/min。
- 湿度：10.785%RH → 7.298%RH。
- 加热输出：71% → 100%，期间峰值 100%。

## 停机状态

开盖动态记录结束后，停止命令已确认；加热输出 0、电机关闭、运行状态 false。之后的分析不再启动加热。

## 文件

- `temperature_test_analysis.svg`：完整温度、输出、湿度过程图。
- `lid_dynamic_response.svg`：开盖 10 秒动态放大图。
- `metrics.json`：机器可读指标。
- `samples.csv`：435 条逐秒/逐样本记录。
- `raw_status.jsonl`：435 条原始网关状态记录。
- `gateway_history.csv`：网关导出的历史数据。
