neiaHsing/stm32-filament-dryer/outputs/pid_tuning/EXPERIMENTS.md

# 40°C 积分分离 PID 实机实验

已完成三轮实验，推荐第三组作为当前装置、当前环境的较优参数。第三轮是热机验证，尚未验证不同装载量和环境下的性能，不宣称全局最优。

## 实现与参数单位

- STM32 本地闭环，反馈取 AHT20/BMP280 两者较高温度；两传感器未做计量校准，结果为传感器示值稳定性。
- 每秒计算一次：u = Kp·e + I − Kd·filtered(dT/dt)，输出限制 0–1000 千分比。
- 仅在 |e| ≤ 分离阈值时积分，饱和时条件积分防止累积；停机/故障/目标变化复位状态。
- 微分对测量值计算，使用时间常数 3 秒的一阶低通。
- Kp 单位：千分比/°C；Ki：千分比/(°C·s)；Kd：千分比·s/°C。
- 推荐值：Kp=100、Ki=1、Kd=600、分离阈值=6°C。若按 0–100% 输出表示，对应 10、0.1、60。
- TIM4_CH3/PB8 加热 PWM 为 10 Hz；CCR 预装载在周期边界更新，占空比归零时立即关输出。
- 实机 SWD 读取：PSC=0x1c1f=7199，ARR=0x3e7=999；72 MHz/(7199+1)/(999+1)=10 Hz。这是寄存器配置验证，未使用示波器测量波形。
- 调节期间电机为 100% 输出；保留风扇/传感器/过温联锁及 5 秒远程租约。异常处理器调用直接寄存器关断。

## 实测对比

| 轮次 | Kp / Ki / Kd | 分离阈值 | 初始温度 | 时长 | 峰值 | 最后120秒范围 | 最后120秒平均绝对误差 |
|---|---|---|---|---|---|---|---|
| 1 | 80 / 1 / 120 | 3°C | 28.72°C | 287s | 36.93°C | 36.45–36.93°C | 3.268°C |
| 2 | 80 / 2 / 120 | 6°C | 36.40°C | 419s | 41.50°C | 39.61–39.95°C | 0.302°C |
| 3 | 100 / 1 / 600 | 6°C | 37.92°C | 600s | 40.15°C | 40.03–40.09°C | 0.059°C |

第一轮在约 36.9°C 停滞，误差仍大于 3°C，积分未介入，提前结束。第二轮扩大积分区并提高 Ki，能到达目标但超调 1.50°C，并出现衰减振荡。第三轮降低 Ki、加强微分后，峰值超调降至 0.15°C，约第 200 秒进入 ±0.2°C 并持续保持到第 600 秒，约 6 分 40 秒。最后两分钟峰峰值 0.06°C，平均示值约 40.059°C。

三轮初始温度和测试时长不同，因此不直接比较冷机升温时间；最后两分钟统计也不等同于无限时间稳态保证。

## 记录与验证

- `trial_*.csv`：上位机轮询记录，HTTP 往返使实际间隔约 1.1 秒，个别 MCU 帧未被轮询保存。
- `gateway_history_after_trial03.csv`：ESP32 导出的每秒原始历史，包含第三轮完整运行区间及部分前后数据。
- `metrics.json`：各轮指标；`analyze.py` 可重新生成。
- `run_trial.py`：有时限实验工具，异常或到时发送 STOP，传感器无效、数据过期、故障或温度大于 43°C 时提前停止。
- PID 行为单元测试、STM32 编译、烧录校验及 git diff --check 已通过。
- 最终固件 SHA256：c7a79d46fb651f1f9791bf50847ec219bd6aaf4c55977b1c0098941da0e54775。
- 实验完成后已核实 STOP 应用，目标40°C、湿度控制禁用、加热/电机关闭、无故障。持续加热尚未启动：自动审批要求用户对实验后持续运行另行确认。
