neiaHsing/stm32-filament-dryer/outputs/pid_tuning/EXPERIMENTS_50C.md

# 50°C 积分分离 PID 优化

用户要求从60°C切换到50°C。已结束60°C试验进程并确认STOP、输出为0，再开始50°C试验。
控制反馈为两个温度传感器的较高值，PID周期1秒，加热PWM为10Hz。每轮有时限并全程监测，温度超过53°C、传感器失效、风扇或其他故障、持续通信失败时停止，到时自动停机。

## 第一轮：现有参数基准

Kp=100、Ki=1、Kd=600、积分分离阈值6°C，输出单位为0–1000千分比。
初始温度约44.65°C，计划600秒，命令序号20。
数据：target50_trial01_kp100_ki1_kd600_sep6.csv。
结论待实测完成。
