neiaHsing/stm32-filament-dryer/Core/Inc/main.h

#define LED_Pin GPIO_PIN_13
#define LED_GPIO_Port GPIOC
#define BUTTON_Pin GPIO_PIN_1
#define BUTTON_GPIO_Port GPIOA
#define MOTOR_IN1_Pin GPIO_PIN_0
#define MOTOR_IN1_GPIO_Port GPIOA
#define MOTOR_IN2_Pin GPIO_PIN_2
#define MOTOR_IN2_GPIO_Port GPIOA
#define FAN_TACH_Pin GPIO_PIN_8
#define FAN_TACH_GPIO_Port GPIOA
#define ENCODER_S2_Pin GPIO_PIN_0
#define ENCODER_S2_GPIO_Port GPIOB
#define ENCODER_KEY_Pin GPIO_PIN_1
#define ENCODER_KEY_GPIO_Port GPIOB
#define OLED_SCL_Pin GPIO_PIN_6
#define OLED_SCL_GPIO_Port GPIOB
#define OLED_SDA_Pin GPIO_PIN_7
#define OLED_SDA_GPIO_Port GPIOB
#define XY_MOS_IN_Pin GPIO_PIN_8
#define XY_MOS_IN_GPIO_Port GPIOB
#define FLASH_CS_Pin GPIO_PIN_9
#define FLASH_CS_GPIO_Port GPIOB
#define SENSOR_SCL_Pin GPIO_PIN_10
#define SENSOR_SCL_GPIO_Port GPIOB
#define SENSOR_SDA_Pin GPIO_PIN_11
#define SENSOR_SDA_GPIO_Port GPIOB
#define ENCODER_S1_Pin GPIO_PIN_12
#define ENCODER_S1_GPIO_Port GPIOB
