neiaHsing/stm32-filament-dryer/Core/Inc/separation_pid.h

#ifndef SEPARATION_PID_H
#define SEPARATION_PID_H
#include <math.h>
#include "ambient_temperature.h"
struct SeparationPid {
  // Output units are permille. Integral is the residual around feedforward.
  static constexpr float feedforwardSlopePermillePerC = 11.99435f;
  static constexpr float feedforwardOffsetC = 12.83620f;
  float integral = 0, previous = 0, derivative = 0;
  float previousTarget = 0, previousOutput = 0, heatMemory = 0;
  float recoveryHold = 0, predictedTemperature = 0;
  bool ready = false;
  static float clamp(float value, float low, float high) {
    return value < low ? low : (value > high ? high : value);
  }
  // Smoothed full-duty rates from the 2026-09-16 measurement, C/s.
  // The startup transient is excluded; endpoints are held outside calibration.
  static float fullPowerRate(float temperature) {
    const float t[] = {35.5f, 40.5f, 45.5f, 50.5f, 55.5f, 59.5f};
    const float r[] = {0.4533f, 0.4346f, 0.3619f, 0.2761f, 0.2058f, 0.1420f};
    if (temperature <= t[0]) return r[0];
    for (unsigned i = 1; i < 6; ++i) {
      if (temperature <= t[i]) {
        const float fraction = (temperature - t[i-1]) / (t[i] - t[i-1]);
        return r[i-1] + fraction * (r[i] - r[i-1]);
      }
    }
    return r[5];
  }
  static float holdingPower(float target,
                            float ambient = AMBIENT_TEMPERATURE_DEFAULT_C) {
    // Two holding-duty points at 24 C, normalized to 22 C (2026-09-17).
    // See outputs/feedforward_calibration_24c/metrics.json.
    // Scale by the target-to-ambient
    // temperature difference so a colder room receives more holding power.
    const float referenceDelta = target - AMBIENT_TEMPERATURE_DEFAULT_C;
    if (referenceDelta <= 0 || ambient >= target) return 0;
    const float baseline = clamp(
        feedforwardSlopePermillePerC * (target - feedforwardOffsetC),
        0, 850);
    return clamp(baseline * (target - ambient) / referenceDelta, 0, 850);
  }
  void reset() {
    integral = derivative = previousOutput = heatMemory = recoveryHold = 0;
    ready = false;
  }
  float step(float target, float measured, float dt, float kp, float ki,
             float kd, float separation,
             float ambient = AMBIENT_TEMPERATURE_DEFAULT_C) {
    // dt==0 is a setpoint-only update on the same sensor sample.
    if (dt < 0 || dt > 5.0f || (dt == 0 && (!ready || measured != previous))) {
      reset(); return 0;
    }
    const float error = target - measured;
    const float slope = ready && dt > 0 ? (measured - previous) / dt : 0;
    const bool targetChanged = ready && target != previousTarget;
    if (targetChanged && target < previousTarget) {
      // Discard positive excess correction on a downward setpoint change.
      integral = integral < 0 ? integral : 0;
    }
    // Preserve measured slope and holding correction when the setpoint rises.
    derivative += (dt / (1.0f + dt)) * (slope - derivative);
    heatMemory += (dt / (4.0f + dt)) * (previousOutput - heatMemory);
    recoveryHold = clamp(recoveryHold - dt, 0, 12);
    if (ready && dt > 0 && error > 0.4f && (slope < -0.10f || derivative < -0.05f))
      recoveryHold = 12;
    if (targetChanged) recoveryHold = recoveryHold < 5 ? 5 : recoveryHold;

    const float rate = fullPowerRate(measured);
    const float gain = clamp(0.4346f / rate, 0.8f, 2.0f);
    const float rising = derivative > 0 ? derivative : 0;
    // Full-power cutoff suggests ~1.65 s; include extra margin at high power.
    // Do not subtract a second stored-heat term: measured rise already includes
    // that effect and trial01 showed excessive braking followed by a 0.4 C dip.
    const float horizon = 1.7f + 0.5f * clamp(heatMemory, 0, 1000) * 0.001f;
    predictedTemperature = measured + horizon * rising;
    const float predictedError = target - predictedTemperature;
    const float p = kp * gain * predictedError;
    // Rising-temperature D braking; falling correction is separately capped.
    const float d = -kd * gain * rising;
    const float feedforward = holdingPower(target, ambient);
    // Near the setpoint, catch a falling temperature before error grows.
    // Approximate rate-to-duty conversion from full-duty heating data; cap the
    // transient at 10 percentage points. Large drops still use P + held I.
    const float coolingBoost = error > -0.20f && error <= 2.0f && derivative < 0
        ? clamp(-derivative * (1000.0f - feedforward) / rate, 0, 100)
        : 0;
    // Regulate continuously across the setpoint. Absolute overtemperature
    // shutdown remains independently enforced by UpdateControl.
    constexpr float ceiling = 1000.0f;

    // Integral correction is allowed throughout the separation band. During a
    // rising approach, reduce its rate instead of freezing it at a fixed
    // slope threshold. This lets the controller build the holding correction
    // while it is still climbing from 38 to 40 C, without banking the full
    // correction as quickly as it would while stationary.
    if (fabsf(error) <= separation && recoveryHold == 0 &&
        !(error > 0 && predictedError <= 0)) {
      const float risingIntegralScale =
          error > 0 && derivative > 0
              ? clamp(1.0f - derivative / 0.30f, 0.25f, 1.0f)
              : 1.0f;
      const float candidate = clamp(
          integral + ki * gain * error * dt * risingIntegralScale,
          -250, 250);
      const float raw = feedforward + p + candidate + d + coolingBoost;
      if ((raw >= 0 && raw <= ceiling) || (raw > ceiling && error < 0) ||
          (raw < 0 && error > 0)) integral = candidate;
    }
    previous = measured;
    previousTarget = target;
    ready = true;
    previousOutput = clamp(feedforward + p + integral + d + coolingBoost,
                           0, ceiling);
    return previousOutput;
  }
};
#endif
