neiaHsing/stm32-filament-dryer/esp32_gateway/main/index_html.h

unsigned char s_index_html[] = {
  0x3c, 0x21, 0x64, 0x6f, 0x63, 0x74, 0x79, 0x70, 0x65, 0x20, 0x68, 0x74,
  0x6d, 0x6c, 0x3e, 0x0a, 0x3c, 0x68, 0x74, 0x6d, 0x6c, 0x20, 0x6c, 0x61,
  0x6e, 0x67, 0x3d, 0x22, 0x7a, 0x68, 0x2d, 0x43, 0x4e, 0x22, 0x3e, 0x0a,
  0x3c, 0x68, 0x65, 0x61, 0x64, 0x3e, 0x0a, 0x20, 0x20, 0x3c, 0x6d, 0x65,
  0x74, 0x61, 0x20, 0x63, 0x68, 0x61, 0x72, 0x73, 0x65, 0x74, 0x3d, 0x22,
  0x75, 0x74, 0x66, 0x2d, 0x38, 0x22, 0x3e, 0x0a, 0x20, 0x20, 0x3c, 0x6d,
  0x65, 0x74, 0x61, 0x20, 0x6e, 0x61, 0x6d, 0x65, 0x3d, 0x22, 0x76, 0x69,
  0x65, 0x77, 0x70, 0x6f, 0x72, 0x74, 0x22, 0x20, 0x63, 0x6f, 0x6e, 0x74,
  0x65, 0x6e, 0x74, 0x3d, 0x22, 0x77, 0x69, 0x64, 0x74, 0x68, 0x3d, 0x64,
  0x65, 0x76, 0x69, 0x63, 0x65, 0x2d, 0x77, 0x69, 0x64, 0x74, 0x68, 0x2c,
  0x69, 0x6e, 0x69, 0x74, 0x69, 0x61, 0x6c, 0x2d, 0x73, 0x63, 0x61, 0x6c,
  0x65, 0x3d, 0x31, 0x22, 0x3e, 0x0a, 0x20, 0x20, 0x3c, 0x74, 0x69, 0x74,
  0x6c, 0x65, 0x3e, 0xe6, 0xb8, 0xa9, 0xe6, 0xb9, 0xbf, 0xe5, 0xba, 0xa6,
  0xe6, 0x8e, 0xa7, 0xe5, 0x88, 0xb6, 0xe5, 0x8f, 0xb0, 0x3c, 0x2f, 0x74,
  0x69, 0x74, 0x6c, 0x65, 0x3e, 0x0a, 0x20, 0x20, 0x3c, 0x73, 0x74, 0x79,
  0x6c, 0x65, 0x3e, 0x0a, 0x20, 0x20, 0x20, 0x20, 0x3a, 0x72, 0x6f, 0x6f,
  0x74, 0x7b, 0x63, 0x6f, 0x6c, 0x6f, 0x72, 0x2d, 0x73, 0x63, 0x68, 0x65,
  0x6d, 0x65, 0x3a, 0x64, 0x61, 0x72, 0x6b, 0x3b, 0x2d, 0x2d, 0x62, 0x67,
  0x3a, 0x23, 0x30, 0x37, 0x31, 0x31, 0x31, 0x66, 0x3b, 0x2d, 0x2d, 0x70,
  0x61, 0x6e, 0x65, 0x6c, 0x3a, 0x23, 0x31, 0x30, 0x31, 0x64, 0x32, 0x64,
  0x3b, 0x2d, 0x2d, 0x6c, 0x69, 0x6e, 0x65, 0x3a, 0x23, 0x32, 0x36, 0x33,
  0x61, 0x35, 0x30, 0x3b, 0x2d, 0x2d, 0x74, 0x65, 0x78, 0x74, 0x3a, 0x23,
  0x65, 0x63, 0x66, 0x34, 0x66, 0x66, 0x3b, 0x2d, 0x2d, 0x6d, 0x75, 0x74,
  0x65, 0x64, 0x3a, 0x23, 0x39, 0x32, 0x61, 0x37, 0x62, 0x64, 0x3b, 0x2d,
  0x2d, 0x61, 0x68, 0x74, 0x3a, 0x23, 0x32, 0x32, 0x64, 0x33, 0x61, 0x36,
  0x3b, 0x2d, 0x2d, 0x68, 0x75, 0x6d, 0x3a, 0x23, 0x66, 0x39, 0x63, 0x37,
  0x34, 0x66, 0x3b, 0x2d, 0x2d, 0x6f, 0x6b, 0x3a, 0x23, 0x32, 0x39, 0x64,
  0x33, 0x39, 0x31, 0x3b, 0x2d, 0x2d, 0x77, 0x61, 0x72, 0x6e, 0x3a, 0x23,
  0x66, 0x66, 0x62, 0x38, 0x34, 0x64, 0x3b, 0x2d, 0x2d, 0x62, 0x61, 0x64,
  0x3a, 0x23, 0x66, 0x66, 0x36, 0x36, 0x37, 0x61, 0x7d, 0x0a, 0x20, 0x20,
  0x20, 0x20, 0x2a, 0x7b, 0x62, 0x6f, 0x78, 0x2d, 0x73, 0x69, 0x7a, 0x69,
  0x6e, 0x67, 0x3a, 0x62, 0x6f, 0x72, 0x64, 0x65, 0x72, 0x2d, 0x62, 0x6f,
  0x78, 0x7d, 0x62, 0x6f, 0x64, 0x79, 0x7b, 0x6d, 0x61, 0x72, 0x67, 0x69,
  0x6e, 0x3a, 0x30, 0x3b, 0x62, 0x61, 0x63, 0x6b, 0x67, 0x72, 0x6f, 0x75,
  0x6e, 0x64, 0x3a, 0x72, 0x61, 0x64, 0x69, 0x61, 0x6c, 0x2d, 0x67, 0x72,
  0x61, 0x64, 0x69, 0x65, 0x6e, 0x74, 0x28, 0x63, 0x69, 0x72, 0x63, 0x6c,
  0x65, 0x20, 0x61, 0x74, 0x20, 0x32, 0x30, 0x25, 0x20, 0x2d, 0x31, 0x30,
  0x25, 0x2c, 0x23, 0x31, 0x36, 0x33, 0x36, 0x35, 0x36, 0x20, 0x30, 0x2c,
  0x74, 0x72, 0x61, 0x6e, 0x73, 0x70, 0x61, 0x72, 0x65, 0x6e, 0x74, 0x20,
  0x33, 0x38, 0x25, 0x29, 0x2c, 0x76, 0x61, 0x72, 0x28, 0x2d, 0x2d, 0x62,
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
};
unsigned int s_index_html_len = 28762;
