neiaHsing/stm32-filament-dryer/Core/Src/oled_font.c

#include <stdint.h>

const uint8_t ascii_font[128][16] = {
{0x00,0x00,0x00,0x00,0x00,0x00,0x00,0x00,0x00,0x00,0x00,0x00,0x00,0x00,0x00,0x00},/*" ",0*/

{0x00,0xFE,0x02,0x02,0x02,0x02,0x02,0x02,0x00,0x3F,0x20,0x20,0x20,0x20,0x20,0x20},/*"",1*/

{0x00,0x00,0x00,0x00,0x00,0x00,0x00,0x00,0x00,0x00,0x00,0x00,0x00,0x00,0x00,0x00},/*"",2*/

{0x00,0xFE,0x02,0x02,0x02,0x02,0x02,0x02,0x00,0x3F,0x20,0x20,0x20,0x20,0x20,0x20},/*"",3*/

{0x00,0xFE,0x02,0x02,0x02,0x02,0x02,0x02,0x00,0x3F,0x20,0x20,0x20,0x20,0x20,0x20},/*"",4*/

{0x00,0xFE,0x02,0x02,0x02,0x02,0x02,0x02,0x00,0x3F,0x20,0x20,0x20,0x20,0x20,0x20},/*"",5*/

{0x00,0xFE,0x02,0x02,0x02,0x02,0x02,0x02,0x00,0x3F,0x20,0x20,0x20,0x20,0x20,0x20},/*"",6*/

{0x00,0xFE,0x02,0x02,0x02,0x02,0x02,0x02,0x00,0x3F,0x20,0x20,0x20,0x20,0x20,0x20},/*"",7*/

{0x00,0xFE,0x02,0x02,0x02,0x02,0x02,0x02,0x00,0x3F,0x20,0x20,0x20,0x20,0x20,0x20},/*"",8*/

{0x00,0x00,0x00,0x00,0x00,0x00,0x00,0x00,0x00,0x00,0x00,0x00,0x00,0x00,0x00,0x00},/*"	",9*/

{0x00,0x00,0x00,0x00,0x00,0x00,0x00,0x00,0x00,0x00,0x00,0x00,0x00,0x00,0x00,0x00},/*" ",10*/

{0x00,0x00,0x00,0x00,0x00,0x00,0x00,0x00,0x00,0x00,0x00,0x00,0x00,0x00,0x00,0x00},/*" ",11*/

{0x00,0xFE,0x02,0x02,0x02,0x02,0x02,0x02,0x00,0x3F,0x20,0x20,0x20,0x20,0x20,0x20},/*"",12*/

{0x00,0xFE,0x02,0x02,0x02,0x02,0x02,0x02,0x00,0x3F,0x20,0x20,0x20,0x20,0x20,0x20},/*"",13*/

{0x00,0xFE,0x02,0x02,0x02,0x02,0x02,0x02,0x00,0x3F,0x20,0x20,0x20,0x20,0x20,0x20},/*"",14*/

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

{0x80,0x80,0x80,0x00,0x00,0x80,0x80,0x80,0x00,0x81,0x86,0x78,0x18,0x06,0x01,0x00},/*"y",121*/

{0x00,0x80,0x80,0x80,0x80,0x80,0x80,0x00,0x00,0x21,0x30,0x2C,0x22,0x21,0x30,0x00},/*"z",122*/

{0x00,0x00,0x00,0x00,0x00,0xFC,0x02,0x02,0x00,0x00,0x00,0x00,0x01,0x3E,0x40,0x40},/*"{",123*/

{0x00,0x00,0x00,0x00,0xFF,0x00,0x00,0x00,0x00,0x00,0x00,0x00,0xFF,0x00,0x00,0x00},/*"|",124*/

{0x02,0x02,0xFC,0x00,0x00,0x00,0x00,0x00,0x40,0x40,0x3E,0x01,0x00,0x00,0x00,0x00},/*"}",125*/

{0x00,0x02,0x01,0x02,0x02,0x04,0x02,0x00,0x00,0x00,0x00,0x00,0x00,0x00,0x00,0x00},/*"~",126*/

{0x00,0x00,0x00,0x00,0x00,0x00,0x00,0x00,0x00,0x00,0x00,0x00,0x00,0x00,0x00,0x00}/*"",127*/
};
