neiaHsing/stm32-filament-dryer/Core/Inc/ambient_temperature.h

#ifndef AMBIENT_TEMPERATURE_H
#define AMBIENT_TEMPERATURE_H

/* Shared menu/storage bounds; six bits encode -10..50 C as 0..60. */
#define AMBIENT_TEMPERATURE_DEFAULT_C 22
#define AMBIENT_TEMPERATURE_MIN_C (-10)
#define AMBIENT_TEMPERATURE_MAX_C 50

#endif
