neiaHsing/stm32-filament-dryer/(commit log)

2026-07-16 Add STM32 filament dryer controller
    [stm32f103c8_blue_pill.cfg]
2026-07-25 Add dryer motor control and OLED status
2026-09-17 Add ESP32 gateway and update project documentation
2026-09-17 Document PID temperature control algorithm
2026-09-17 Update feedforward control and calibration reports
2026-09-17 Keep ESP32 demo hotspot enabled
